ZRZStudio/Steam-Controller-Chatpad/docs/README.md

# Documentation

[← Project home](../README.md)

This firmware powers the chatpad conversion featured in the [full OG Steam Controller (2015) upgrade and modification video](https://www.youtube.com/watch?v=59sTsHHFOmE) on the **ZRZ YouTube channel**.

<p align="center">
  <a href="https://www.youtube.com/watch?v=59sTsHHFOmE">
    Watch the full OG Steam Controller (2015) upgrade and modification video on the ZRZ YouTube channel
  </a>
</p>

| Guide | Contents |
| :--- | :--- |
| [Getting started](GETTING_STARTED.md) | Parts, software, uploading, pairing, and initial checks. |
| [Wiring](WIRING.md) | UART, Green-switch isolation, and the optional divider. |
| [Controls and settings](CONTROLS.md) | Modifiers, host slots, menu paths, and LED feedback. |
| [Configuration](CONFIGURATION.md) | Defaults, power behaviour, BLE options, and calibration. |
| [Troubleshooting](TROUBLESHOOTING.md) | Common symptoms and practical checks. |
