ZRZStudio/Steam-Controller-Chatpad/docs/assets/2.png

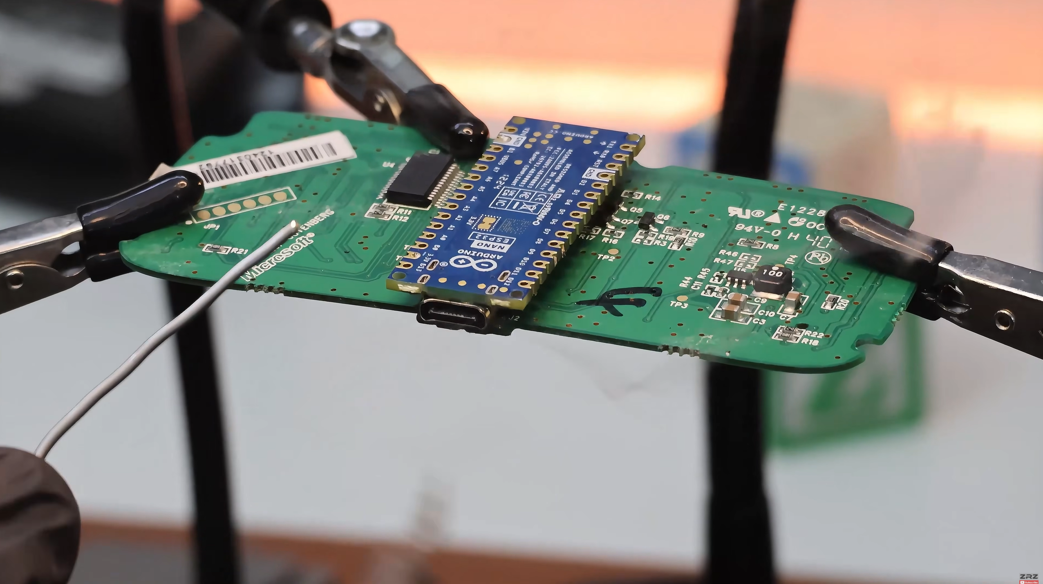
docs/assets/2.png
