ZRZStudio/Steam-Controller-Chatpad/CHANGELOG.md

# Changelog

All notable public changes to Steam Chatpad will be documented here.

## Unreleased

### Documentation

- Added setup, configuration, and troubleshooting guides.
- Expanded wiring notes, menu paths, modifier shortcuts, and LED feedback.
- Clarified UK layout requirements, host-dependent symbols, and supply-monitor limitations.
- Added contributor guidance, a pull request template, and detailed issue templates.
- Firmware behaviour is unchanged from v1.0.0.

## 1.0.0 - 2026-09-11

Initial public release.
