ZRZStudio/Steam-Controller-Chatpad/(notices)

Notices in the files:
README.md:
MIT license
